MoratoZ/Trabalho-Final-Acionamento-Eletronico-de-Motores-AEML8/(list of files, cad)

Other CAD files:
Diagramas-AutoCAD.dwg
