MoratoZ/Trabalho-Final-Acionamento-Eletronico-de-Motores-AEML8/(commit log)

2025-11-24 Rename Relação IOs.xlsx to ProjetoFinal-RelaçãoIOs.xlsx
    [ProjetoFinal-RelaçãoIOs.xlsx]
2025-11-24 Rename Trabalho Final - Diagramas - autocad.dwg to ProjetoFinal-DiagramasAutoCAD.dwg
    [ProjetoFinal-DiagramasAutoCAD.dwg]
2025-11-24 Rename ProjetoFinal-DiagramasAutoCAD.dwg to Diagramas - AutoCAD.dwg
    [Diagramas - AutoCAD.dwg]
2025-11-24 Rename Diagramas - AutoCAD.dwg to Diagramas-AutoCAD.dwg
    [Diagramas-AutoCAD.dwg]
